ROBOTEAMCRV/REXBOT2.0/Fotos_del_REXBOT2.0/parte inferior vista desde arriba.png

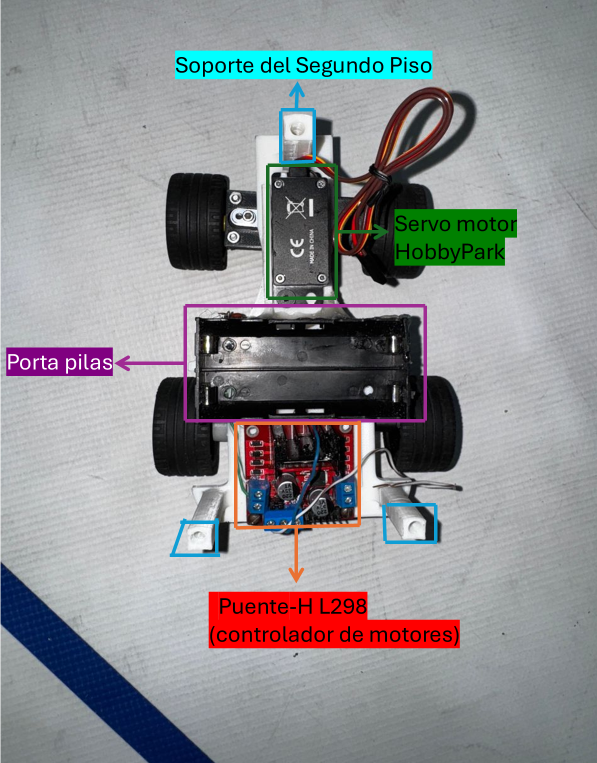
Fotos_del_REXBOT2.0/parte inferior vista desde arriba.png
