ROBOTEAMCRV/REXBOT2.0/Fotos_del_REXBOT2.0/vista superior.jpeg

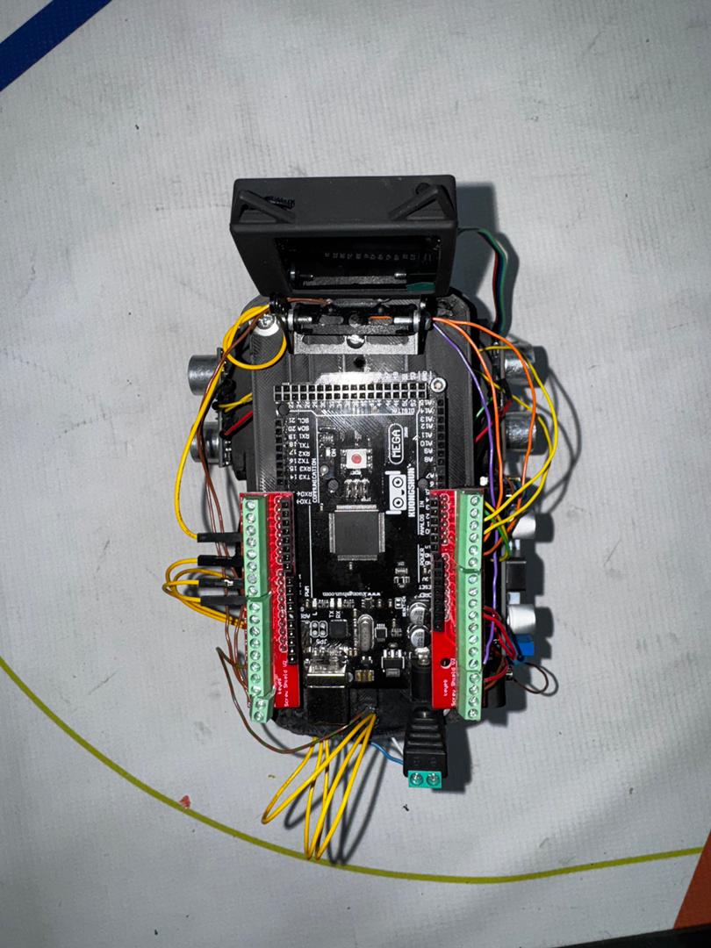
Fotos_del_REXBOT2.0/vista superior.jpeg
