ROBOTEAMCRV/REXBOT2.0/Archivos_CAD/README.md

Aqui se encuentran los archivos CAD utilizados para elaborar a REXBOT2.0
