ROBOTEAMCRV/REXBOT2.0/Videos/README.md

aqui se encuentran los links de los videos de REXBOT2.0 realizando los diferentes desafios

https://youtu.be/DbEMKiIEqTA?si=5kwMHXraeFq_aoY7

https://youtu.be/VE3UerniF68?si=

https://youtu.be/NERKy564aRw?si=hIvsrn8uq7AC7gY3
