ROBOTEAMCRV/REXBOT2.0/Codigo/README.md

se realizaron mejoras en el codigo 2daronda_3.0_2025062819212
para lograr un mayor rendimiento y ejecucion
