ROBOTEAMCRV/REXBOT2.0/Fotos_del_REXBOT2.0/tercer piso.png

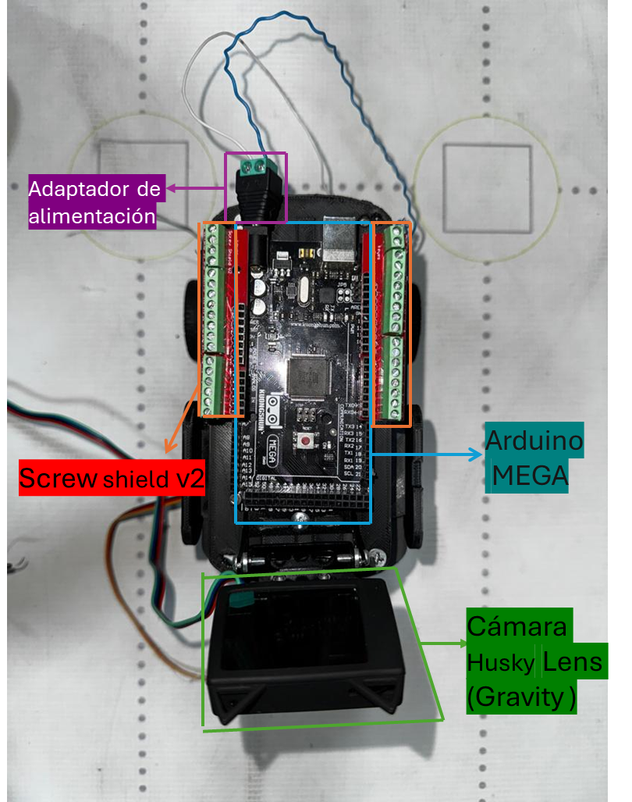
Fotos_del_REXBOT2.0/tercer piso.png
