ROBOTEAMCRV/REXBOT2.0/Fotos_del_REXBOT2.0/vista lateral derecho.jpeg

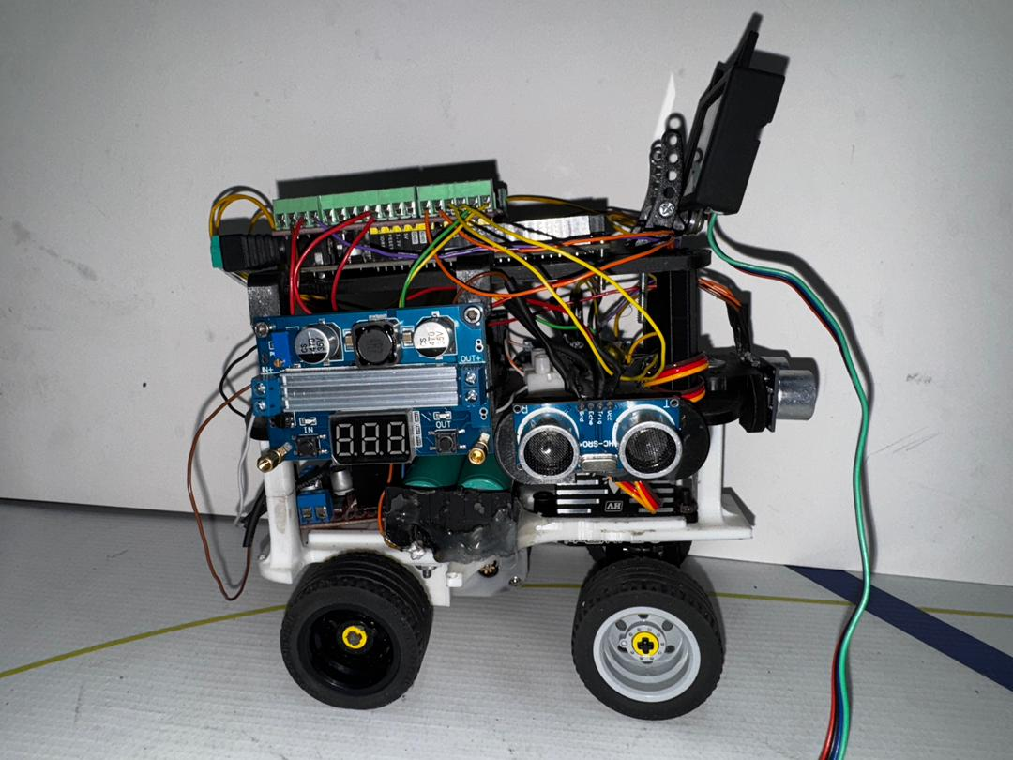
Fotos_del_REXBOT2.0/vista lateral derecho.jpeg
