ROBOTEAMCRV/REXBOT2.0/Archivos_CAD/Archivos CAD/BASESESORESREXBOT2.0 (2).stl

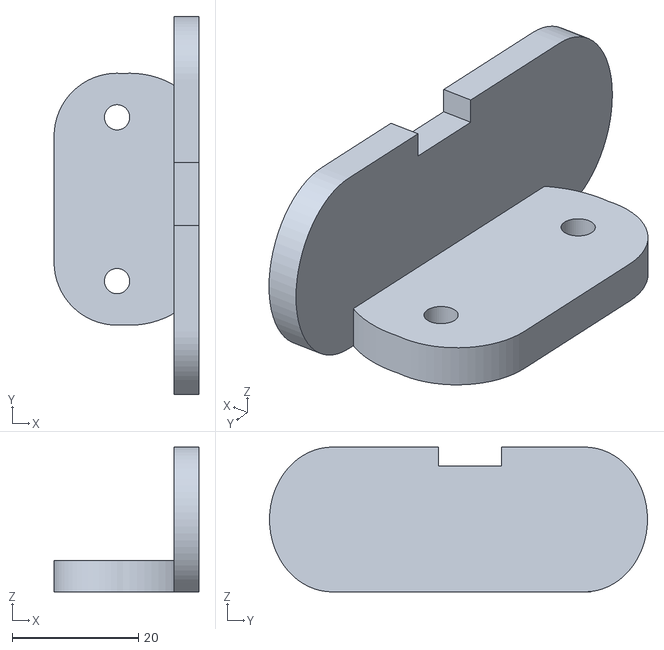
[picture p26: CAD file, 2025-08-25]
Archivos_CAD/Archivos CAD/BASESESORESREXBOT2.0 (2).stl
23.0 x 60.0 x 23.0
