ROBOTEAMCRV/REXBOT2.0/Archivos_CAD/Archivos CAD/SOPORTETRENDELANTEROREXBOT2.0.stl

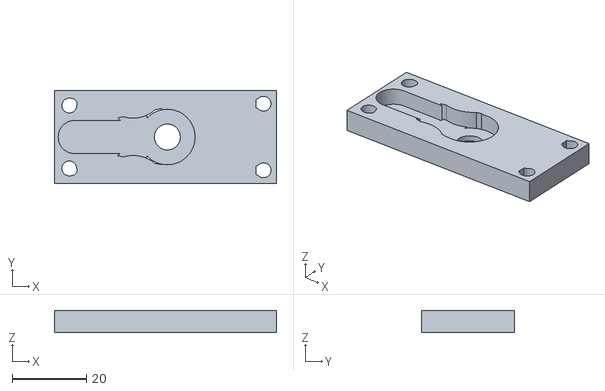
[picture p27: CAD file, 2025-08-25]
Archivos_CAD/Archivos CAD/SOPORTETRENDELANTEROREXBOT2.0.stl
60.0 x 25.0 x 6.00
