ROBOTEAMCRV/REXBOT2.0/Archivos_CAD/Archivos CAD/SEGUNDOPISOREXBOT2.0.stl

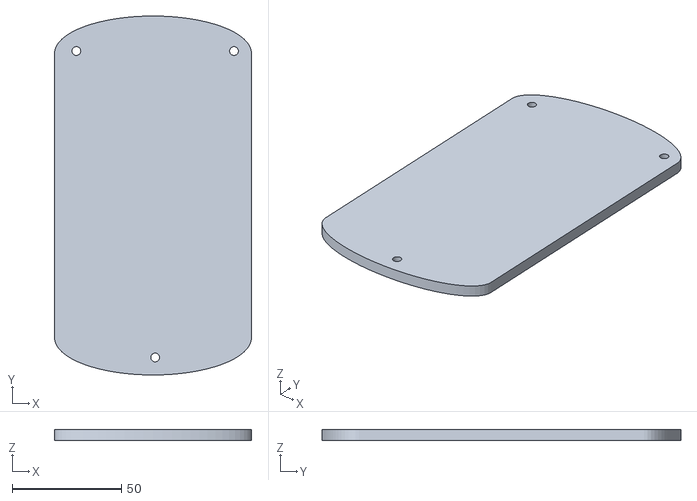
[picture p28: CAD file, 2025-08-25]
Archivos_CAD/Archivos CAD/SEGUNDOPISOREXBOT2.0.stl
90.0 x 164.0 x 5.00
