ROBOTEAMCRV/REXBOT2.0/Archivos_CAD/Archivos CAD/BASETERCERPISOREXBOT2.0.stl

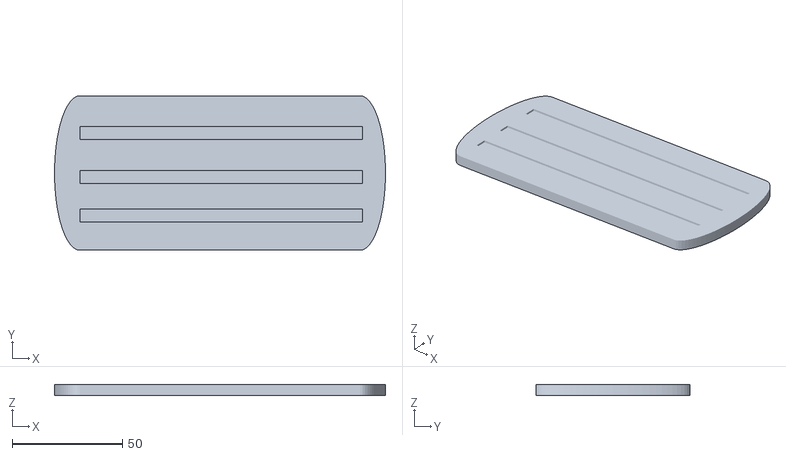
[picture p29: CAD file, 2025-08-25]
Archivos_CAD/Archivos CAD/BASETERCERPISOREXBOT2.0.stl
150.0 x 70.0 x 5.00
