ROBOTEAMCRV/REXBOT2.0/Archivos_CAD/Archivos CAD/base tercer piso.stl

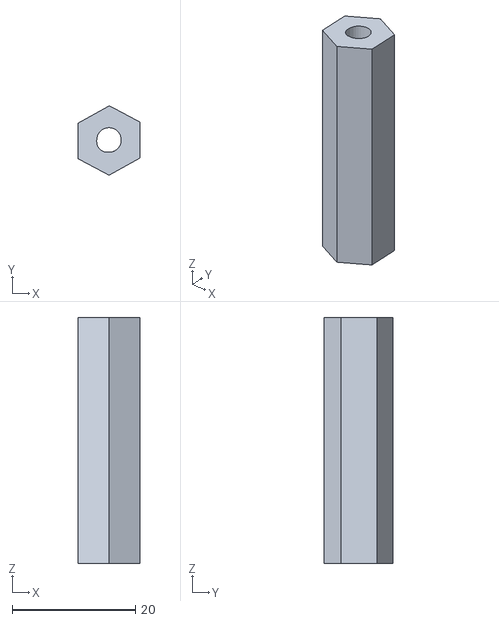
[picture p30: CAD file, 2025-08-25]
Archivos_CAD/Archivos CAD/base tercer piso.stl
10.0 x 11.3 x 40.0
