ROBOTEAMCRV/REXBOT2.0/Archivos_CAD/Archivos CAD/soporteelevador.stl

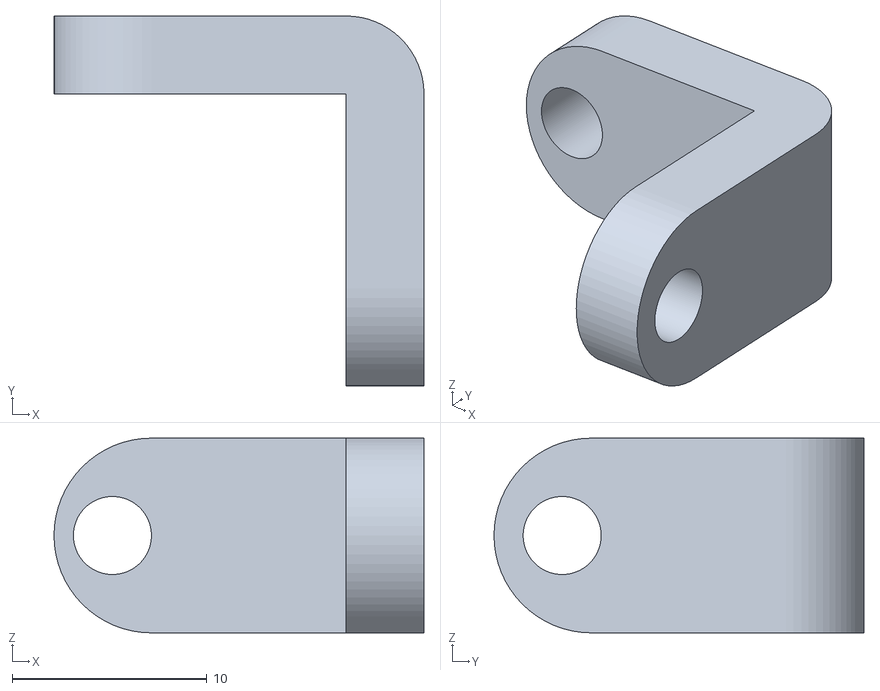
[picture p31: CAD file, 2025-08-25]
Archivos_CAD/Archivos CAD/soporteelevador.stl
19.0 x 19.0 x 10.0
