ROBOTEAMCRV/REXBOT2.0/Archivos_CAD/Archivos CAD/DEFISOPORTMOTOREXBOT2.0.stl

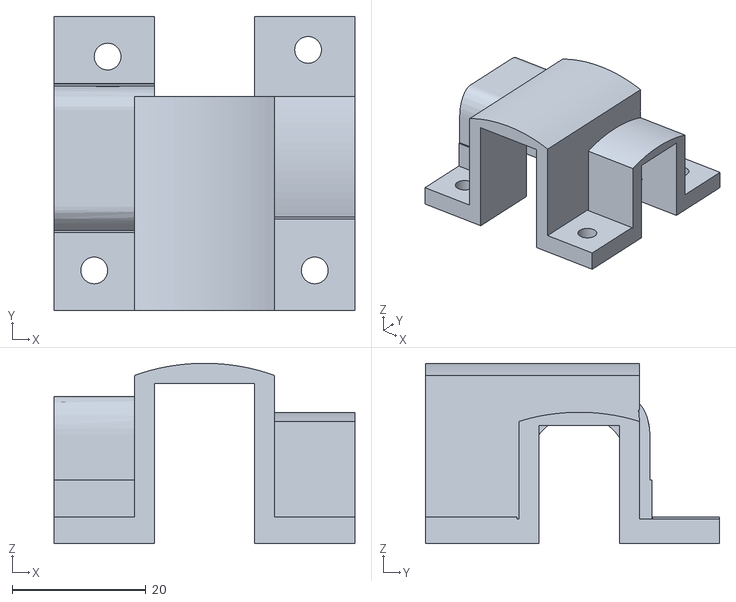
[picture p32: CAD file, 2025-08-25]
Archivos_CAD/Archivos CAD/DEFISOPORTMOTOREXBOT2.0.stl
45.0 x 44.0 x 27.0
