ROBOTEAMCRV/REXBOT2.0/Archivos_CAD/Archivos CAD/BASEREXBOT2.0.stl

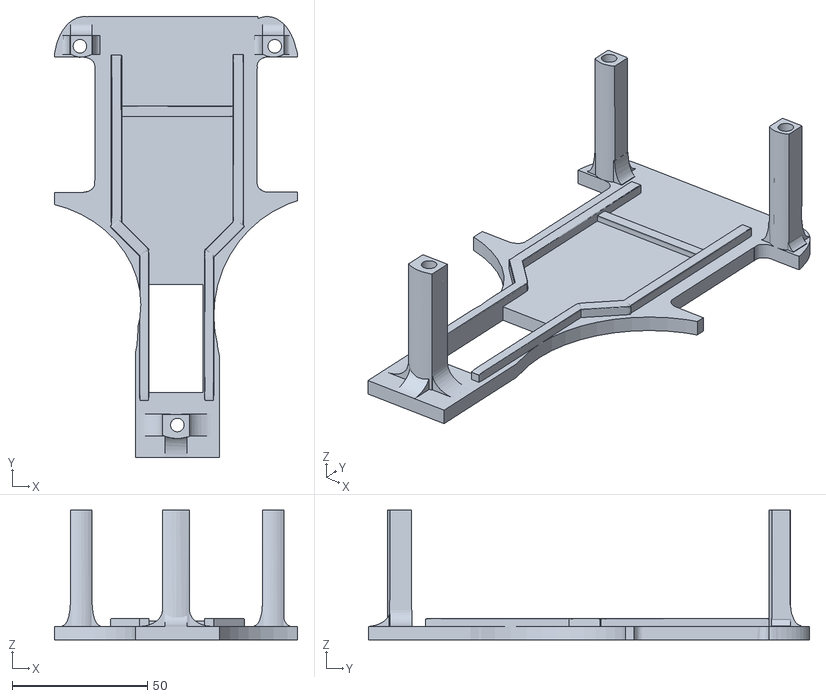
[picture p33: CAD file, 2025-08-25]
Archivos_CAD/Archivos CAD/BASEREXBOT2.0.stl
90.0 x 163.0 x 48.0
