ROBOTEAMCRV/REXBOT2.0/Archivos_CAD/Archivos CAD/sopobuje (2).stl

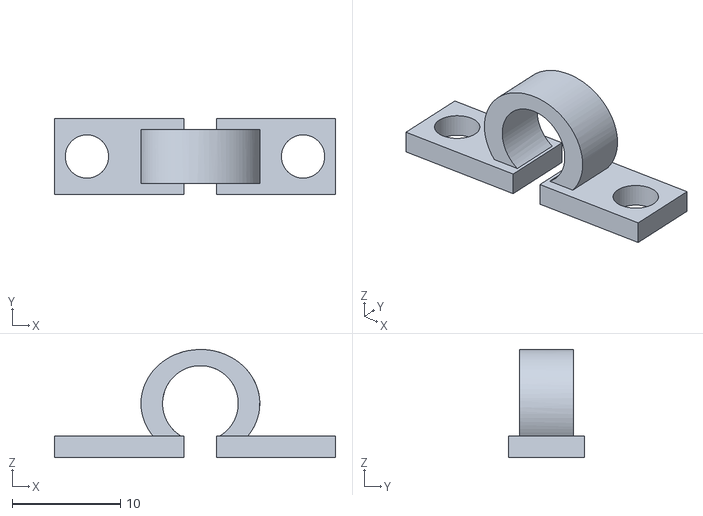
[picture p34: CAD file, 2025-08-25]
Archivos_CAD/Archivos CAD/sopobuje (2).stl
26.0 x 7.00 x 10.00
