ROBOTEAMCRV/REXBOT2.0/(list of files, drawings)

Other design files:
REXBOT2.0.pdsprj
