ROBOTEAMCRV/REXBOT2.0/(commit log)

2025-06-15 Add files via upload
    codigo y programacion de REXBOT 2.0
2025-06-15 Add files via upload
    ARCHIVOS CAD. Piezas con las que se construyó REXBOT 2.0
    [DEFISOPORTMOT.stl, base 1.stl, base de servo.stl, soporte eje del servo.stl, sopote 3er piso.stl]
2025-06-15 Add files via upload
    Fotos de la construcción paso a paso de REXBOT 2.0
2025-06-15 Add files via upload
    Videos del funcionamiento de REXBOT 2.0
2025-06-15 README.md
    README de la carpeta archivos CAD
2025-06-15 README.md
    Se creo el readme de la carpeta codigo
2025-06-15 README.md
    Se creo el readme de la carpeta fotos
2025-06-15 README.md
    se creo el readme de la carpeta videos
2025-06-15 Link de video
    video de pruebas de rexbot2.0 en youtube
2025-06-19 ESQUEMATICO
    Este es el esquema electrico de REXBOT2.0 donde se detalla todas y cada una de las conexiones electricas de nuestro prototipo.
    Motor traccion trasera (DC 5V) conectado a un controlador de motores( L298N).
    Servo motor MG996R que funciona como direccion de ruedas delanteras.
    Sensores ultrasonicos(3) HC-SR04 para medir distancias a las paredes.
    Camara Huskylens para detectar los colores de los objetos (señales de trafico).
    Arduino Mega 2560 como controlador del Ptototipo.
    [REXBOT2.0.pdsprj]
2025-06-29 Add files via upload
    se realizaron mejoras y adaptaciones para una ejecución optima
2025-08-08 README.md
    actualización de la información previa a la que se tenia anteriormente se introdujeron nuevos avances y mejoras.
2025-08-08 actualizacion de fotos
2025-08-08 Add files via upload
    fotos actualizadas de REXBOT2.0
2025-08-08 IDEAS Y PRINCIPIOS
    ideas que tomamos para realizar el proyecto
2025-08-24 README.md
    corrección de readme
2025-08-25 correcciones de archivos
2025-08-25 Add files via upload
    Aquí se puede encontrar los archivos STL de los diseños 3D con los que se realizo REXBOT2.0 pueden observar diversas partes de su estructura en las que se implemento el usos de una impresora 3D.
    [BASEREXBOT2.0.stl, BASESESORESREXBOT2.0 (2).stl, BASETERCERPISOREXBOT2.0.stl, DEFISOPORTMOTOREXBOT2.0.stl, SEGUNDOPISOREXBOT2.0.stl, SOPORTETRENDELANTEROREXBOT2.0.stl, base tercer piso.stl, sopobuje (2).stl]
